the-user-created/EEE3088F-Team-9/README.md

# EEE3088F 2022 HAT Project

# License
[Creative Commons Attribution 4.0 International license](https://choosealicense.com/licenses/cc-by-4.0/)
