the-user-created/EEE3088F-Team-9/CAD/CAD_readme.md

# Project CAD files
This folder should contain files related to mechanical design for the project such as 3D printing or other container design files.
