the-user-created/EEE3088F-Team-9/Other/GROUP9_BOM.xlsx

 | Component Name | JLCPCB Code | Count (per board) | Cost ($) | Total Cost ($)
POWER | 1Ω Resistor | C17928 | 2 | 0.0051 | 0.0102
 | 1.2kΩ Resistor | C22765 | 3 | 0.0013 | 0.0039
 | 100kΩ Resistor | C17900 | 1 | 0.0038 | 0.0038
 | 33kΩ Resistor | C4216 | 1 | 0.0013 | 0.0013
 | Red LED | C84256 | 1 | 0.0136 | 0.0136
 | Green LED | C72043 | 1 | 0.0296 | 0.0296
 | 10uF Capacitor | C13585 | 3 | 0.0409 | 0.1227
 | 22uF Capacitor | C12891 | 3 | 0.0735 | 0.2205
 | 1uF Capacitor | C28323 | 1 | 0.0096 | 0.0096
 | 0.47uF Capacitor | C47339 | 1 | 0.002 | 0.002
 | Schottky diode | C8598 | 1 | 0.042 | 0.042
 | Battery mgmt IC | C16581 | 1 | 0.256 | 0.256
 | MCP6002 Op-amp | C7377 | 1 | 0.4035 | 0.4035
 | Inductor | C408336 | 1 | 0.2225 | 0.2225 | EXTENDED
 | Voltage booster | C130338 | 1 | 0.2937 | 0.2937 | EXTENDED
 | P-channel MOSFET | C8492 | 1 | 0.0273 | 0.0273
 | Voltage regulator | C140319 | 1 | 1.4949 | 1.4949 | EXTENDED
 | Total |  |  | $ | 3.1571 | plus $9 Ext
INTERFACING | Zener diode | C8056 | 3 | 0.0176 | 0.0528
 | Green LED | C72043 | 2 | 0.0296 | 0.0592
 | 0.1uF Capacitor | C1525 | 2 | 0.001 | 0.002
 | 1.0uF Capacitor | C15849 | 1 | 0.0055 | 0.0055
 | EEPROM IC (CAT24C256) | C6482 | 1 | 1.4287 | 1.4287
 | FTDI IC (CP2102-GMR) | C6568 | 1 | 3.5502 | 3.5502
 | USB Connector (MicroXNJ) | C404969 | 1 | 0.047 | 0.047 | EXTENDED
 | 1.2kΩ Resistor | C22765 | 2 | 0.0013 | 0.0026
 | 4.7kΩ Resistor | C23162 | 1 | 0.0012 | 0.0012
 | 10kΩ Resistor | C25804 | 2 | 0.0012 | 0.0024
 | Total |  |  | $ | 5.1516 | plus $3 Ext
SENSING | 0.1uF Capacitor | C1525 | 1 | 0.001 | 0.001
 | 1.0uF Capacitor | C15849 | 1 | 0.0055 | 0.0055
 | Barometer (LPS22HBTR) | C94049 | 1 | 2.4324 | 2.4324 | EXTENDED
 | Temp Sensor (LM61BIZ/NOPB) | C90846 | 1 | 0.9723 | 0.9723 | EXTENDED
 | Total |  |  | $ | 3.4112 | plus $6 Ext
 | Per Board Total |  |  | $ | 11.7199 | plus $18 Ext
 | 5 Board Total |  |  | $ | 76.5995 | plus $18 Ext
