the-user-created/EEE3088F-Team-9/Other/Sensor BOM.xlsx

Item | Qty | Reference(s) | Description | Value | LibPart | Price per part (approximate) | Total cost ($)
1 | 5 | C1 | Capacitor | 1uF | Device: C | $0.00843 | $0.04215
2 | 5 | C2 | Capacitor | 100nF | Device: C | $0.0011 | $0.0055
3 | 5 | U1 | Nano Barometer |  | C94049_Barometer | $2.6886 | $13.443
4 | 5 | U2 | Temperature Sensor |  | TO-92 Temperature Sensor | $1.0186 | $5.093
 |  |  |  |  |  | Grand Total: | $18.58365
