the-user-created/EEE3088F-Team-9/Other/MC_Interfacing_BOM.xlsx

Collated Components:
Item | Qty | Reference(s) | Description | Value | LibPart | Price per part (approximate) | Total cost ($)
1 | 1 | C7 | Capacitor | 1.0uF | Device:C_Small | $0.0281 | $0.0281
2 | 2 | C8, C9 | Capacitor | 0.1uF | Device:C_Small | $0.0050 | $0.01
3 | 1 | R 13 | Resistor | 4.7k | Device:R_US | $0.0013 | $0.0013
4 | 1 | R 14 | Resistor | 10k | Device:R_US | $0.0007 | $0.0007
5 | 3 | D6, D7, D8 | Zener Diode | N/A | Diode:ZMMxx | $0.0193 | $0.0579
6 | 1 | U6 | Memory Element | N/A | Memory_EEPROM:CAT24C256 | $1.5556 | $1.5556
7 | 1 | J5 | Micro USB Connector | N/A | Connector:USB_B_Micro | $0.2511 | $0.2511
10 | 1 | U7 | FTDI | N/A | custom_symbols:CP2102-GMR | $3.7227 | $3.7227
 |  |  |  |  |  | GRAND TOTAL PER HAT ($) | $5.6274
