the-user-created/EEE3088F-Team-9/Other/POWER_BOM.xlsx

Collated Components:
Item | Qty | Reference(s) | Description | Value | LibPart | Price per part (approximate) | Total cost ($)
1 | 1 | BT1 | Battery holder | Battery | Device:Battery | ???
2 | 2 | C1, C2 | Misc capacitor | C | Device:C | 0.01 | 0.02
3 | 1 | C3 | Exact capacitance | 0.47u | Device:C | 0.01 | 0.01
4 | 1 | C4 | Exact capacitance | 33u | Device:C | 0.01 | 0.01
5 | 2 | D1, D2 | LEDs | LED | Device:LED | 0.01 | 0.02
6 | 2 | D3, D4 | Volt. reg. diodes | D | Device:D | 0.01 | 0.02
7 | 1 | D5 | Zener diode | D_Zener | Device:D_Zener | 0.02 | 0.02
10 | 1 | Q1 | PMOS | Q_PMOS_DGS | Device:Q_PMOS_DGS | 0.2 | 0.2
11 | 12 | R1, R2, R3, R4, R5, R6, R7, R8, R9, R10, R11, R12 | Misc Resistors | R | Device:R | 0.01 | 0.12
12 | 1 | U1 | Battery mgmt. IC | TP4056 | 000_MY_SYMBOLS:TP4056 | 0.2 | 0.2
13 | 1 | U2 | Voltage regulator | LM3940 | 000_MY_SYMBOLS:LM3940 | 1.6 | 1.6
14 | 1 | U3 | Op-amp | OPAMP | pspice:OPAMP | 0.14 | 0.14
 |  |  |  |  |  | GRAND TOTAL PER HAT ($) | 2.36
