the-user-created/EEE3088F-Team-9/PCB/main/main.kicad_pcb

## KiCad design PCB/main/main.kicad_pcb (2022-04-08)

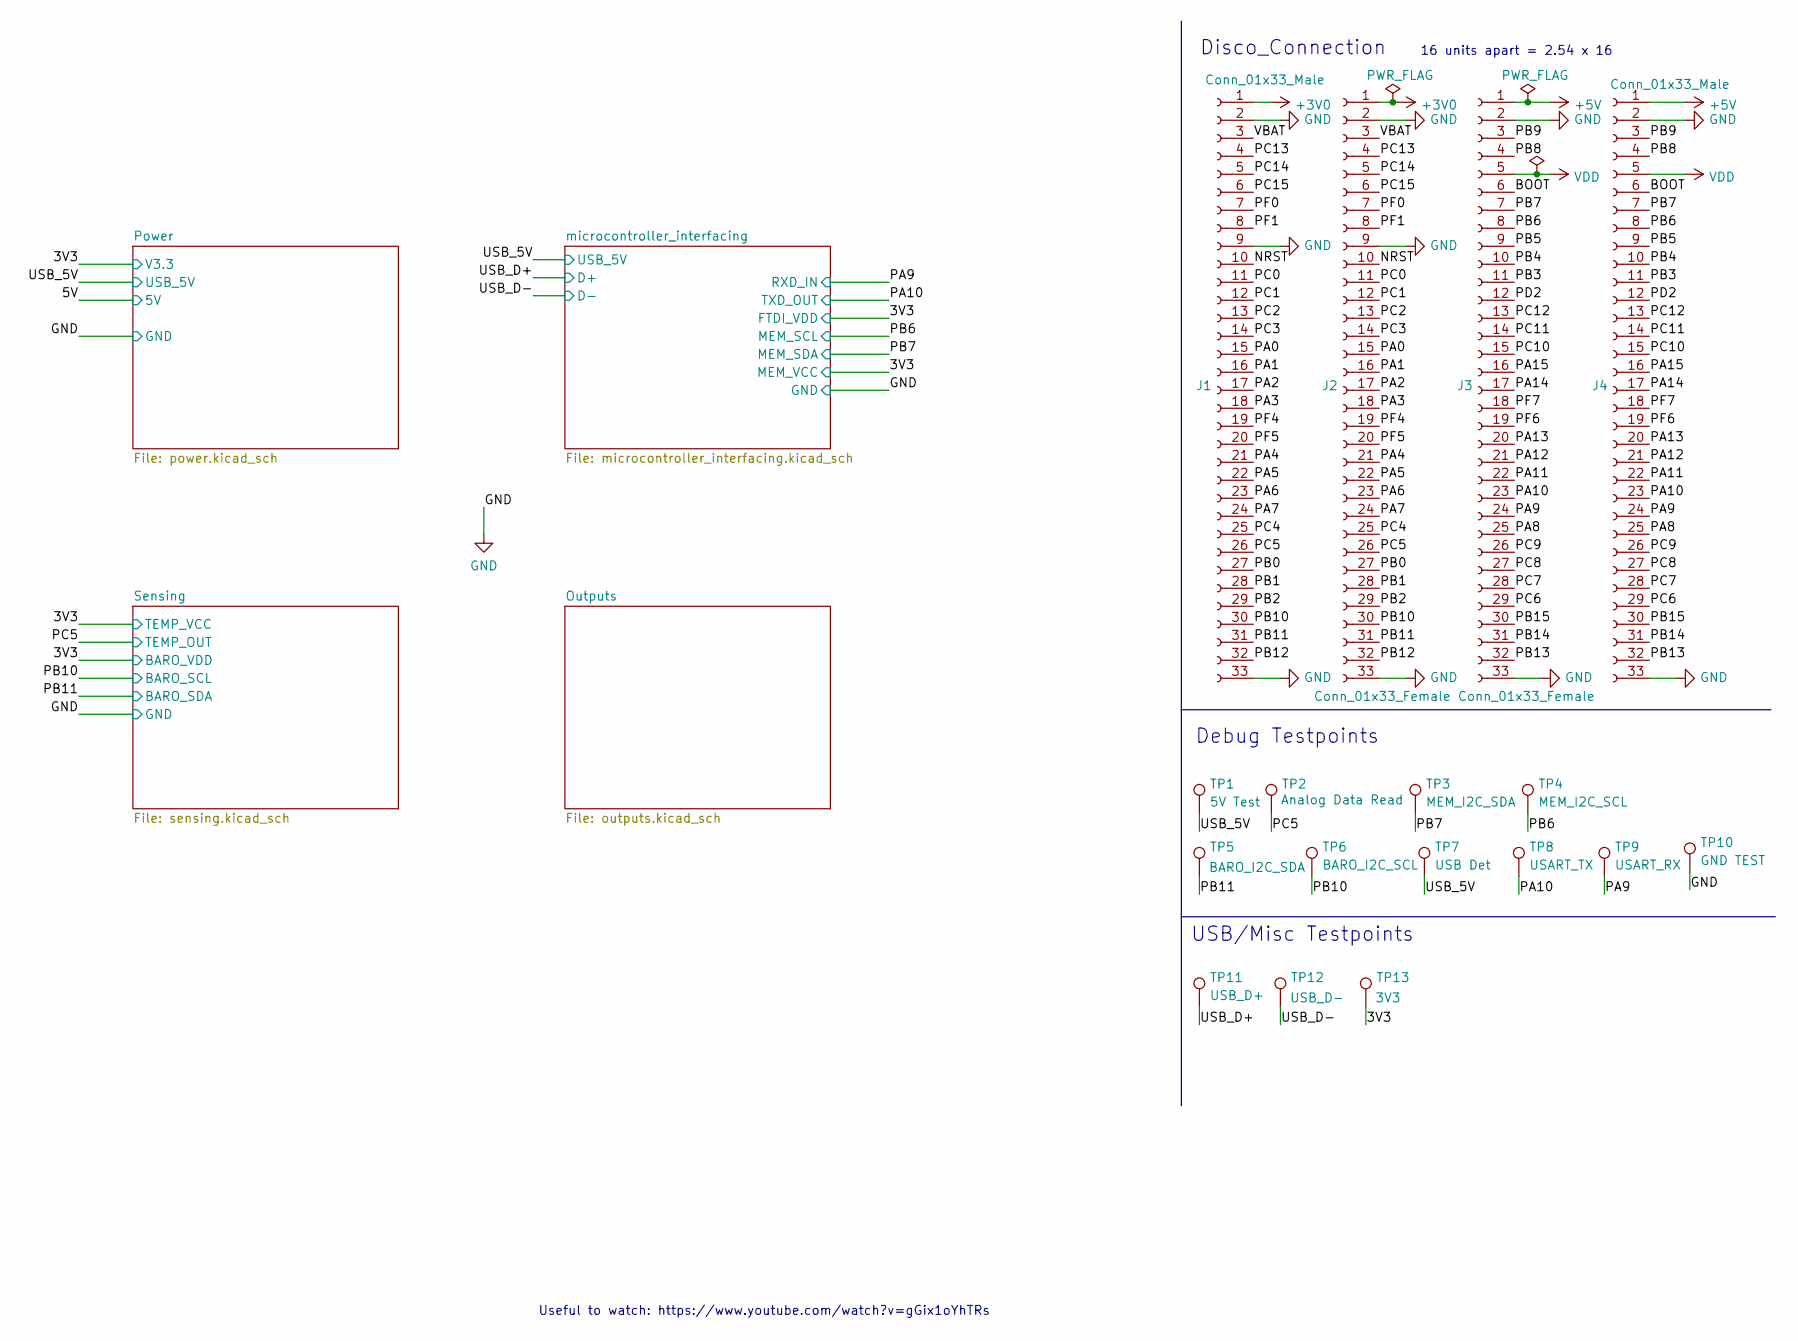
[picture p1: schematic main.kicad_sch, EEE3088F Group 9]

Parts:
J1, J4: Conn_01x33_Male; PinHeader_1x33_P2.54mm_Vertical
J2, J3: Conn_01x33_Female; PinSocket_1x33_P2.54mm_Vertical
TP1: 5V Test; TestPoint_Pad_2.5x2.5mm
TP2: Analog Data Read; TestPoint_Pad_2.5x2.5mm
TP3: MEM_I2C_SDA; TestPoint_Pad_2.5x2.5mm
TP4: MEM_I2C_SCL; TestPoint_Pad_2.5x2.5mm
TP5: BARO_I2C_SDA; TestPoint_Pad_2.5x2.5mm
TP6: BARO_I2C_SCL; TestPoint_Pad_2.5x2.5mm
TP7: USB Det; TestPoint_Pad_2.5x2.5mm
TP8: USART_TX; TestPoint_Pad_2.5x2.5mm
TP9: USART_RX; TestPoint_Pad_2.5x2.5mm
TP10: GND TEST; TestPoint_Pad_2.5x2.5mm
TP11: USB_D+; TestPoint_Pad_2.5x2.5mm
TP12: USB_D-; TestPoint_Pad_2.5x2.5mm
TP13: 3V3; TestPoint_Pad_2.5x2.5mm

Connections:
+3V0: J1.1, J2.1
+5V: J3.1, J4.1
/3V3: TP13.1; also elsewhere on the board
/BOOT: J3.6, J4.6
/NRST: J1.10, J2.10
/PA0: J1.15, J2.15
/PA1: J1.16, J2.16
/PA2: J1.17, J2.17
/PA3: J1.18, J2.18
/PA4: J1.21, J2.21
/PA5: J1.22, J2.22
/PA6: J1.23, J2.23
/PA7: J1.24, J2.24
/PA8: J3.25, J4.25
/PA9: J3.24, J4.24, TP9.1; also elsewhere on the board
/PA10: J3.23, J4.23, TP8.1; also elsewhere on the board
/PA11: J3.22, J4.22
/PA12: J3.21, J4.21
/PA13: J3.20, J4.20
/PA14: J3.17, J4.17
/PA15: J3.16, J4.16
/PB0: J1.27, J2.27
/PB1: J1.28, J2.28
/PB2: J1.29, J2.29
/PB3: J3.11, J4.11
/PB4: J3.10, J4.10
/PB5: J3.9, J4.9
/PB6: J3.8, J4.8, TP4.1; also elsewhere on the board
/PB7: J3.7, J4.7, TP3.1; also elsewhere on the board
/PB8: J3.4, J4.4
/PB9: J3.3, J4.3
/PB10: J1.30, J2.30, TP6.1; also elsewhere on the board
/PB11: J1.31, J2.31, TP5.1; also elsewhere on the board
/PB12: J1.32, J2.32
/PB13: J3.32, J4.32
/PB14: J3.31, J4.31
/PB15: J3.30, J4.30
/PC0: J1.11, J2.11
/PC1: J1.12, J2.12
/PC2: J1.13, J2.13
/PC3: J1.14, J2.14
/PC4: J1.25, J2.25
/PC5: J1.26, J2.26, TP2.1; also elsewhere on the board
/PC6: J3.29, J4.29
/PC7: J3.28, J4.28
/PC8: J3.27, J4.27
/PC9: J3.26, J4.26
/PC10: J3.15, J4.15
/PC11: J3.14, J4.14
/PC12: J3.13, J4.13
/PC13: J1.4, J2.4
/PC14: J1.5, J2.5
/PC15: J1.6, J2.6
/PD2: J3.12, J4.12
/PF0: J1.7, J2.7
/PF1: J1.8, J2.8
/PF4: J1.19, J2.19
/PF5: J1.20, J2.20
/PF6: J3.19, J4.19
/PF7: J3.18, J4.18
/USB_5V: TP1.1, TP7.1; also elsewhere on the board
/USB_D+: TP11.1; also elsewhere on the board
/USB_D-: TP12.1; also elsewhere on the board
/VBAT: J1.3, J2.3
GND: J1.2, J1.9, J1.33, J2.2, J2.9, J2.33, J3.2, J3.33, J4.2, J4.33, TP10.1; also elsewhere on the board
VDD: J3.5, J4.5

Notes on the sheet:
USB/Misc Testpoints
Useful to watch: https://www.youtube.com/watch?v=gGix1oYhTRs
16 units apart = 2.54 x 16
Disco_Connection
Debug Testpoints

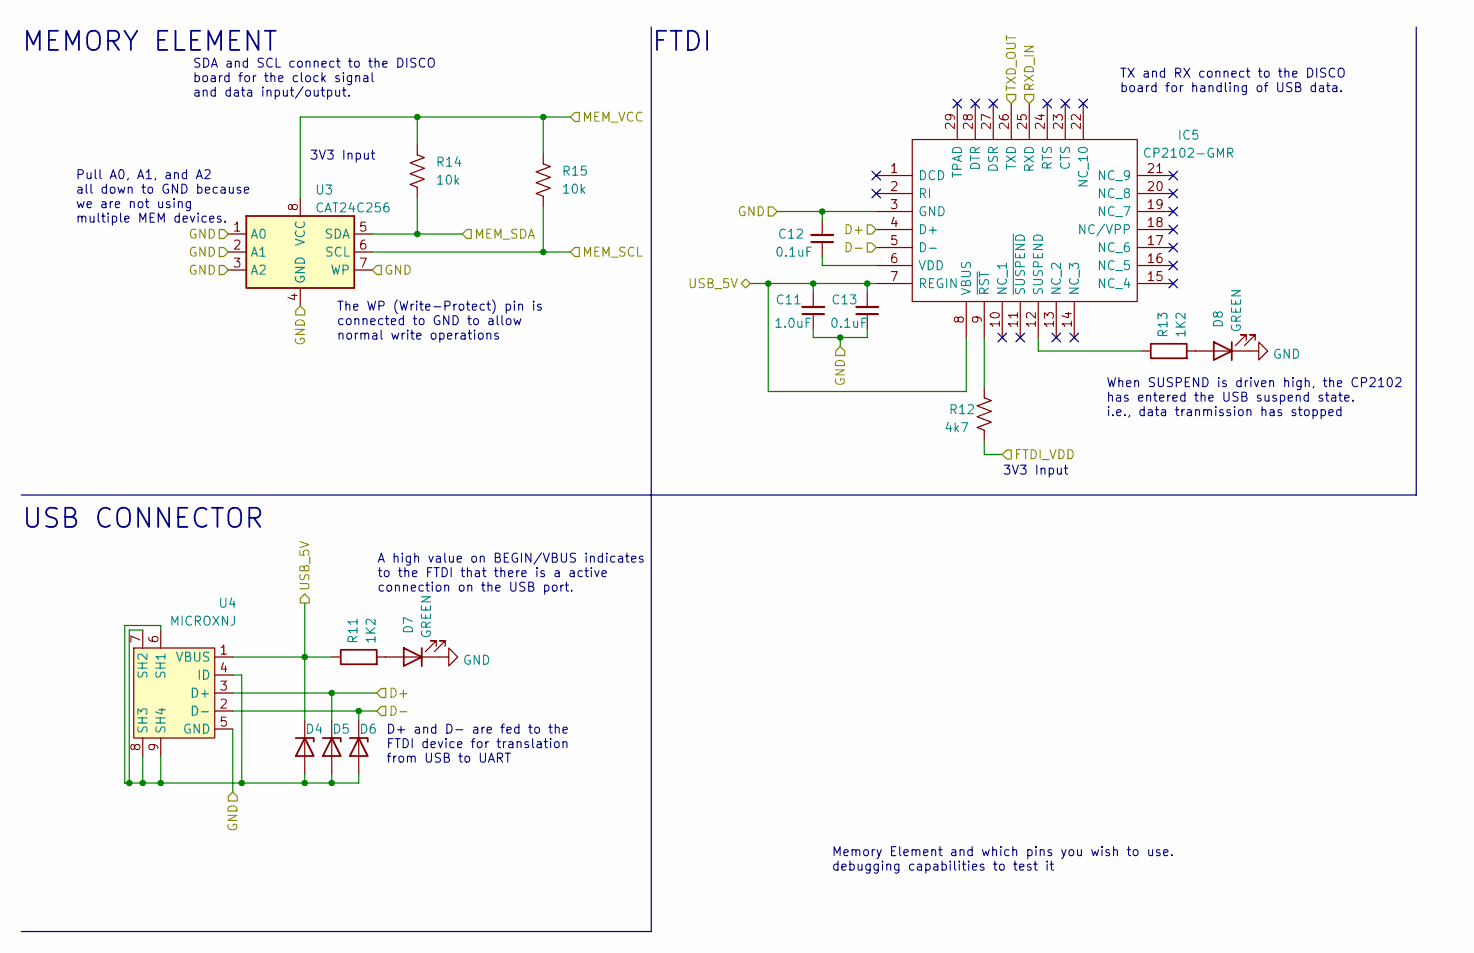
[picture p2: schematic microcontroller_interfacing.kicad_sch, Microcontroller Interfacing Subsystem]

Parts:
C11: 1.0uF; CAPC1608X90N; LCSC C15849
C12, C13: 0.1uF; CAPC1005X55N; LCSC C1525
D4, D5, D6: ZMMxx; LL-34_L3.5-W1.5-RD; LCSC C8056
D7, D8: GREEN; LEDC1608X50N; LCSC C72043
IC5: CP2102-GMR; QFN50P500X500X100-29N-D; Manufacturer_Part_Number CP2102-GMR; Mouser Part Number 634-CP2102-GMR
R11, R13: 1K2; RESC1608X55N; LCSC C22765
R12: 4k7; RESC1608X55N; LCSC C23162
R14, R15: 10k; R0603; LCSC C25804
U3: CAT24C256; SOIC127P600X175-8N; LCSC C6482
U4: MICROXNJ; MICRO-USB-SMD_MICROXNJ; LCSC C404969

Connections:
/3V3: R12.1, R14.1, R15.1, U3.8 (VCC); also elsewhere on the board
/PA9: IC5.25 (RXD); also elsewhere on the board
/PA10: IC5.26 (TXD); also elsewhere on the board
/PB6: R15.2, U3.6 (SCL); also elsewhere on the board
/PB7: R14.2, U3.5 (SDA); also elsewhere on the board
/USB_5V: C11.2, C13.2, D4.1 (K), IC5.7 (REGIN), IC5.8 (VBUS), R11.1, U4.1 (VBUS); also elsewhere on the board
/USB_D+: D5.1 (K), IC5.4 (D+), U4.3 (D+); also elsewhere on the board
/USB_D-: D6.1 (K), IC5.5 (D-), U4.2 (D-); also elsewhere on the board
GND: C11.1, C12.2, C13.1, D7.1 (K), D8.1 (K), IC5.3 (GND), U3.1 (A0), U3.2 (A1), U3.3 (A2), U3.4 (GND), U3.7 (WP), U4.5 (GND); also elsewhere on the board
unnamed: C12.1, IC5.6 (VDD)
unnamed: D4.2 (A), D5.2 (A), D6.2 (A), U4.4 (ID), U4.6 (SH1), U4.7 (SH2), U4.8 (SH3), U4.9 (SH4)
unnamed: D7.2 (A), R11.2
unnamed: D8.2 (A), R13.2
unnamed: IC5.9 (~RST), R12.2
unnamed: IC5.12 (SUSPEND), R13.1

Notes on the sheet:
3V3 Input
SDA and SCL connect to the DISCO board for the clock signal and data input/output.
FTDI
Pull A0, A1, and A2 all down to GND because we are not using multiple MEM devices.
MEMORY ELEMENT
The WP (Write-Protect) pin is connected to GND to allow normal write operations
TX and RX connect to the DISCO board for handling of USB data.
Memory Element and which pins you wish to use. debugging capabilities to test it
A high value on BEGIN/VBUS indicates to the FTDI that there is a active connection on the USB port.
D+ and D- are fed to the FTDI device for translation from USB to UART
When SUSPEND is driven high, the CP2102 has entered the USB suspend state. i.e., data tranmission has stopped
USB CONNECTOR

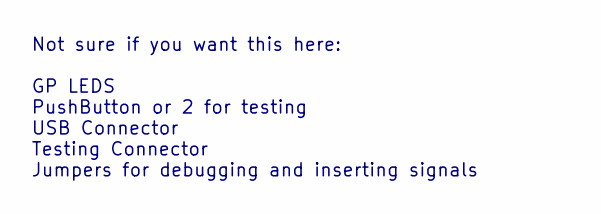
[picture p3: schematic outputs.kicad_sch]

Notes on the sheet:
Not sure if you want this here: GP LEDS PushButton or 2 for testing USB Connector Testing Connector Jumpers for debugging and inserting signals

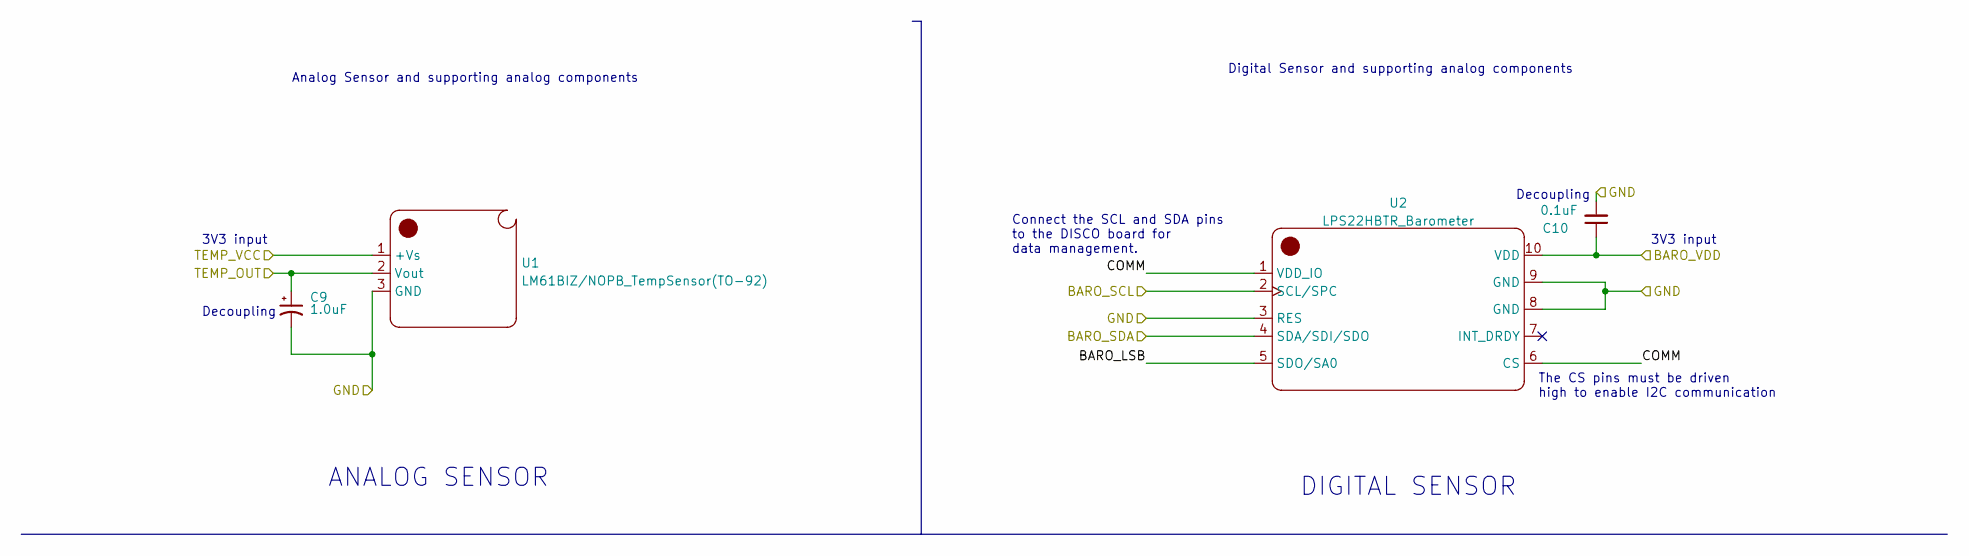
[picture p4: schematic sensing.kicad_sch, Sensing Subsystem]

Parts:
C9: 1.0uF; RESC1608X55N; LCSC C15849
C10: 0.1uF; CAPC1005X55N; LCSC C1525
U1: LM61BIZ/NOPB_TempSensor(TO-92); TO-92-3_L4.9-W3.7-P1.27-L; LCSC C90846
U2: LPS22HBTR_Barometer; QFN50P210X200X80-10N; LCSC C94049

Connections:
/3V3: C10.1, U1.1 (+Vs), U2.10 (VDD); also elsewhere on the board
/PB10: U2.2 (SCL/SPC); also elsewhere on the board
/PB11: U2.4 (SDA/SDI/SDO); also elsewhere on the board
/PC5: C9.1, U1.2 (Vout); also elsewhere on the board
/Sensing/BARO_LSB: U2.5 (SDO/SA0)
/Sensing/COMM: U2.1 (VDD_IO), U2.6 (CS)
GND: C9.2, C10.2, U1.3 (GND), U2.3 (RES), U2.8 (GND), U2.9 (GND); also elsewhere on the board

Notes on the sheet:
DIGITAL SENSOR
Decoupling
Analog Sensor and supporting analog components
3V3 input
ANALOG SENSOR
The CS pins must be driven high to enable I2C communication
Decoupling
Digital Sensor and supporting analog components
Connect the SCL and SDA pins to the DISCO board for data management.

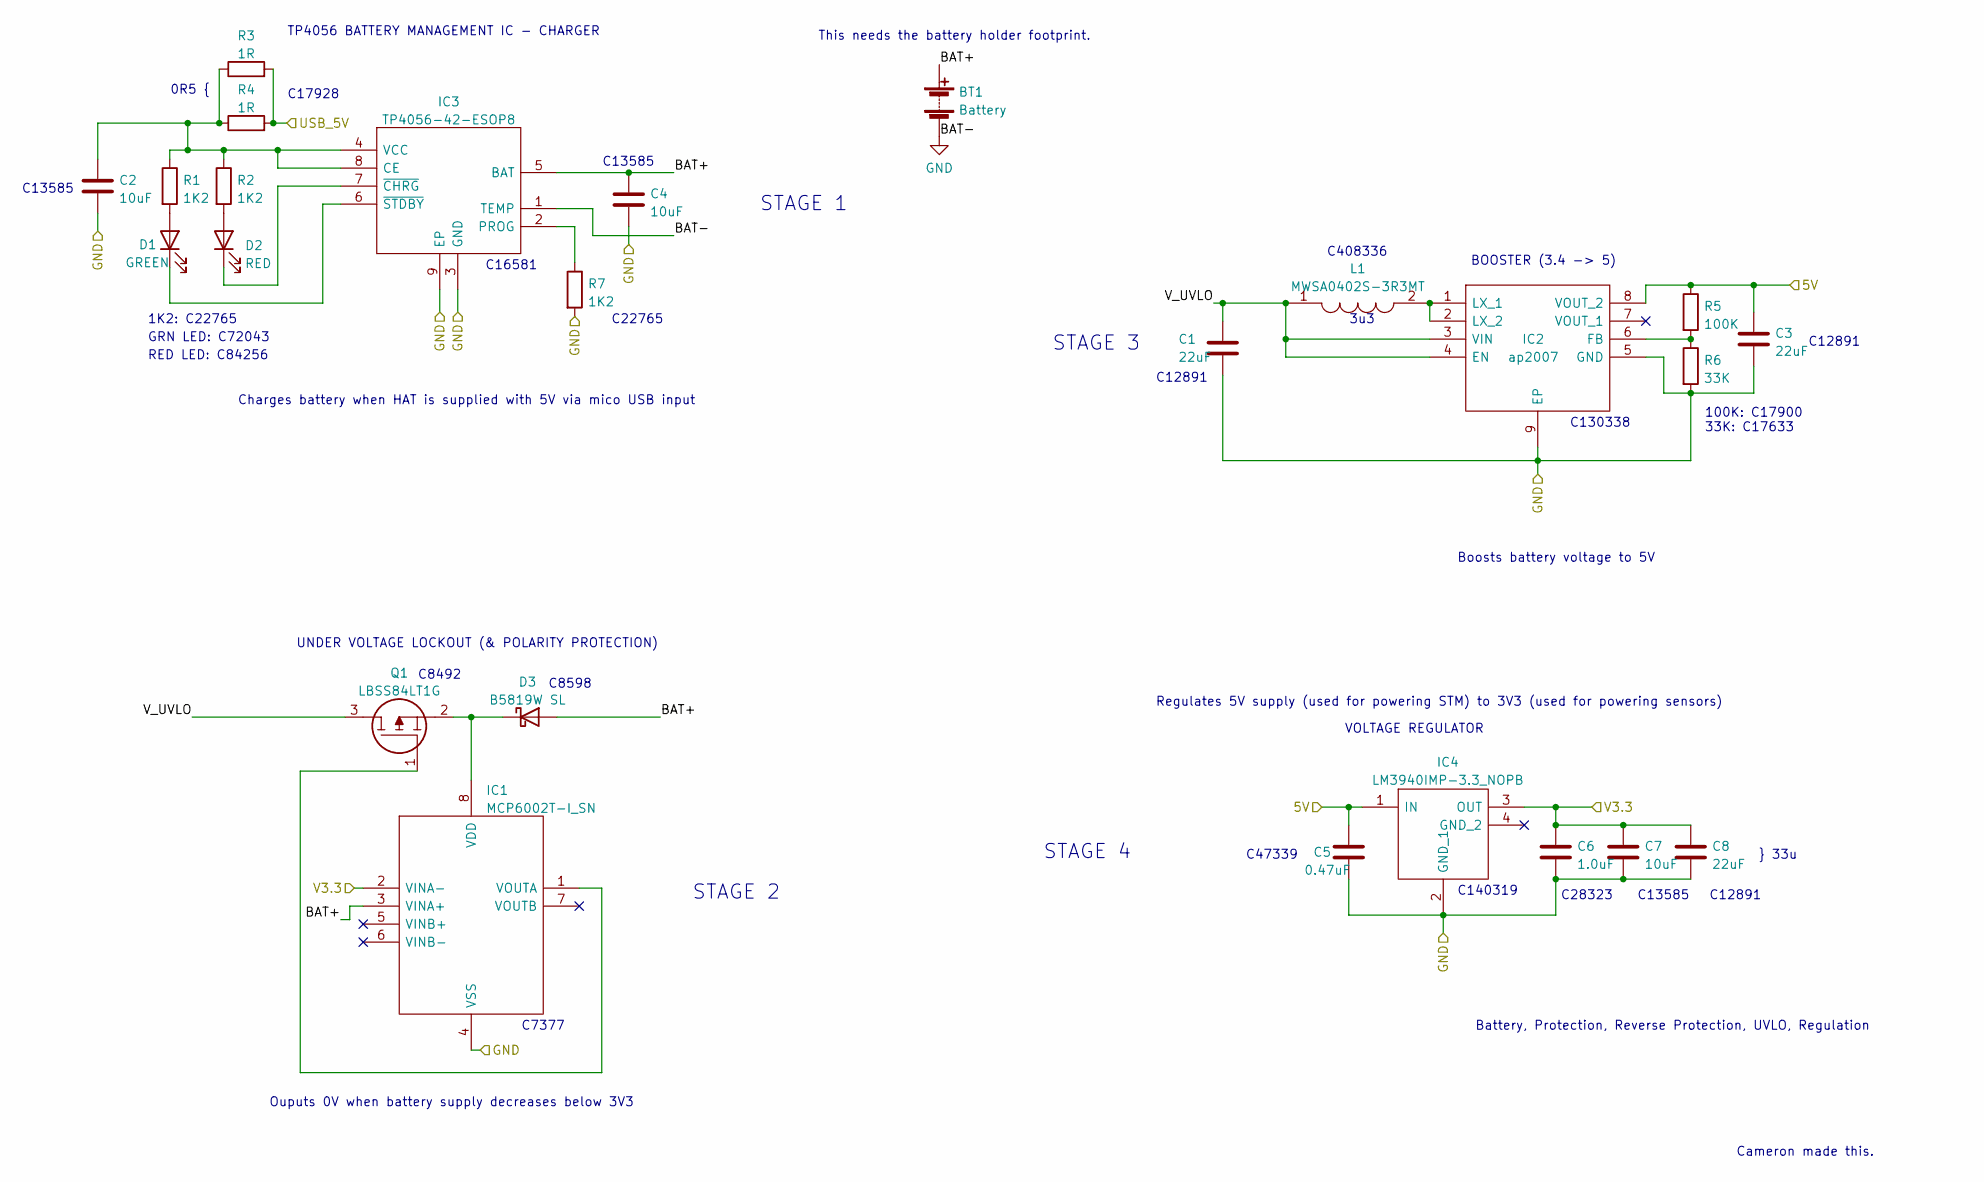
[picture p5: schematic power.kicad_sch, Power Subsystem]

Parts:
BT1: Battery; 18650_Holder_THT
C1, C3, C8: 22uF; CAPC3216X180N; LCSC C12891
C2, C4, C7: 10uF; CAPC3216X180N; LCSC C13585
C5: 0.47uF; CAPC1005X55N; LCSC C47339
C6: 1.0uF; CAPC1608X90N; LCSC C28323
D1: GREEN; LEDC1608X50N; LCSC C72043
D2: RED; LED0805-RD_RED; LCSC C84256
D3: B5819W SL; SOD-123_L2.7-W1.6-LS3.7-RD-1; LCSC C8598
IC1: MCP6002T-I_SN; SOIC127P600X175-8N; Manufacturer_Part_Number MCP6002T-I/SN; Mouser Part Number 579-MCP6002T-I/SN
IC2: ap2007; SOIC127P600X175-9N; Manufacturer_Part_Number ap2007; LCSC C130338
IC3: TP4056-42-ESOP8; SOIC127P600X175-9N; Manufacturer_Part_Number TP4056-42-ESOP8; LCSC C16581
IC4: LM3940IMP-3.3_NOPB; SOT230P700X180-4N; Manufacturer_Part_Number LM3940IMP-3.3/NOPB; Mouser Part Number 926-LM3940IMP3.3NOPB
L1: MWSA0402S-3R3MT; INDPM4442X200N; Manufacturer_Part_Number MWSA0402S-3R3MT; LCSC C408336
Q1: LBSS84LT1G; SOT96P237X111-3N; Manufacturer_Part_Number LBSS84LT1G; Mouser Part Number N/A
R1, R2, R7: 1K2; RESC1608X55N; LCSC C22765
R3, R4: 1R; R1206; LCSC C17928
R5: 100K; RESC3116X65N; LCSC C17900
R6: 33K; R0603; LCSC C4216

Connections:
/3V3: C6.1, C7.1, C8.1, IC1.2 (VINA-), IC4.3 (OUT); also elsewhere on the board
/5V: C3.1, C5.1, IC2.8 (VOUT_2), IC4.1 (IN), R5.1
/Power/BAT+: BT1.1 (+), C4.1, D3.2 (A), IC1.3 (VINA+), IC3.5 (BAT)
/Power/V_UVLO: C1.1, IC2.3 (VIN), IC2.4 (EN), L1.1, Q1.3
/USB_5V: R3.2, R4.2; also elsewhere on the board
GND: BT1.2 (-), C1.2, C2.2, C3.2, C4.2, C5.2, C6.2, C7.2, C8.2, IC1.4 (VSS), IC2.5 (GND), IC2.9 (EP), IC3.1 (TEMP), IC3.3 (GND), IC3.9 (EP), IC4.2 (GND_1), R6.2, R7.2; also elsewhere on the board
unnamed: C2.1, IC3.4 (VCC), IC3.8 (CE), R1.1, R2.1, R3.1, R4.1
unnamed: D1.1 (K), IC3.6 (~STDBY)
unnamed: D1.2 (A), R1.2
unnamed: D2.1 (K), IC3.7 (~CHRG)
unnamed: D2.2 (A), R2.2
unnamed: D3.1 (K), IC1.8 (VDD), Q1.2
unnamed: IC1.1 (VOUTA), Q1.1
unnamed: IC2.1 (LX_1), IC2.2 (LX_2), L1.2
unnamed: IC2.6 (FB), R5.2, R6.1
unnamed: IC3.2 (PROG), R7.1

Notes on the sheet:
C12891
STAGE 4
C17928
This needs the battery holder footprint.
C140319
BOOSTER (3.4 -> 5)
Boosts battery voltage to 5V
C8492
0R5 {
C13585
C28323
Charges battery when HAT is supplied with 5V via mico USB input
STAGE 3
STAGE 1
C22765
C408336
Ouputs 0V when battery supply decreases below 3V3
C16581
100K: C17900 33K: C17633
C130338
3u3
C47339
TP4056 BATTERY MANAGEMENT IC - CHARGER
UNDER VOLTAGE LOCKOUT (& POLARITY PROTECTION)
1K2: C22765
Battery, Protection, Reverse Protection, UVLO, Regulation
VOLTAGE REGULATOR
Regulates 5V supply (used for powering STM) to 3V3 (used for powering sensors)
RED LED: C84256
C7377
GRN LED: C72043
} 33u
Cameron made this.
STAGE 2
C8598

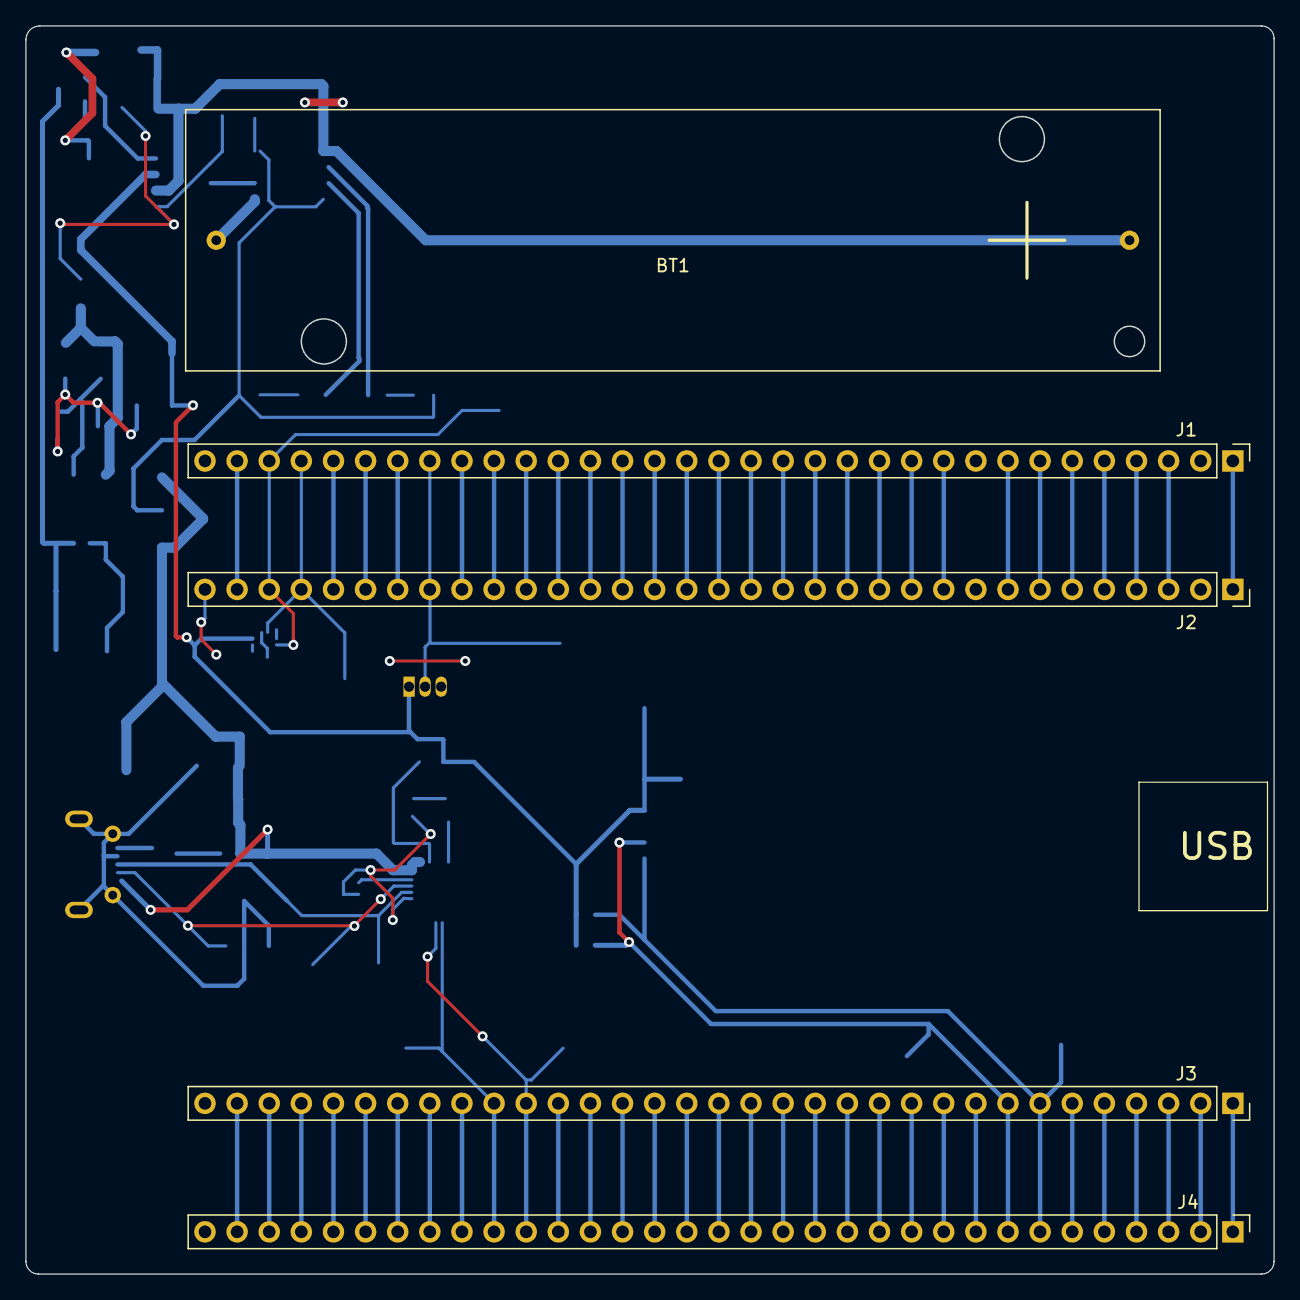
[picture p6: board main.kicad_pcb from above]

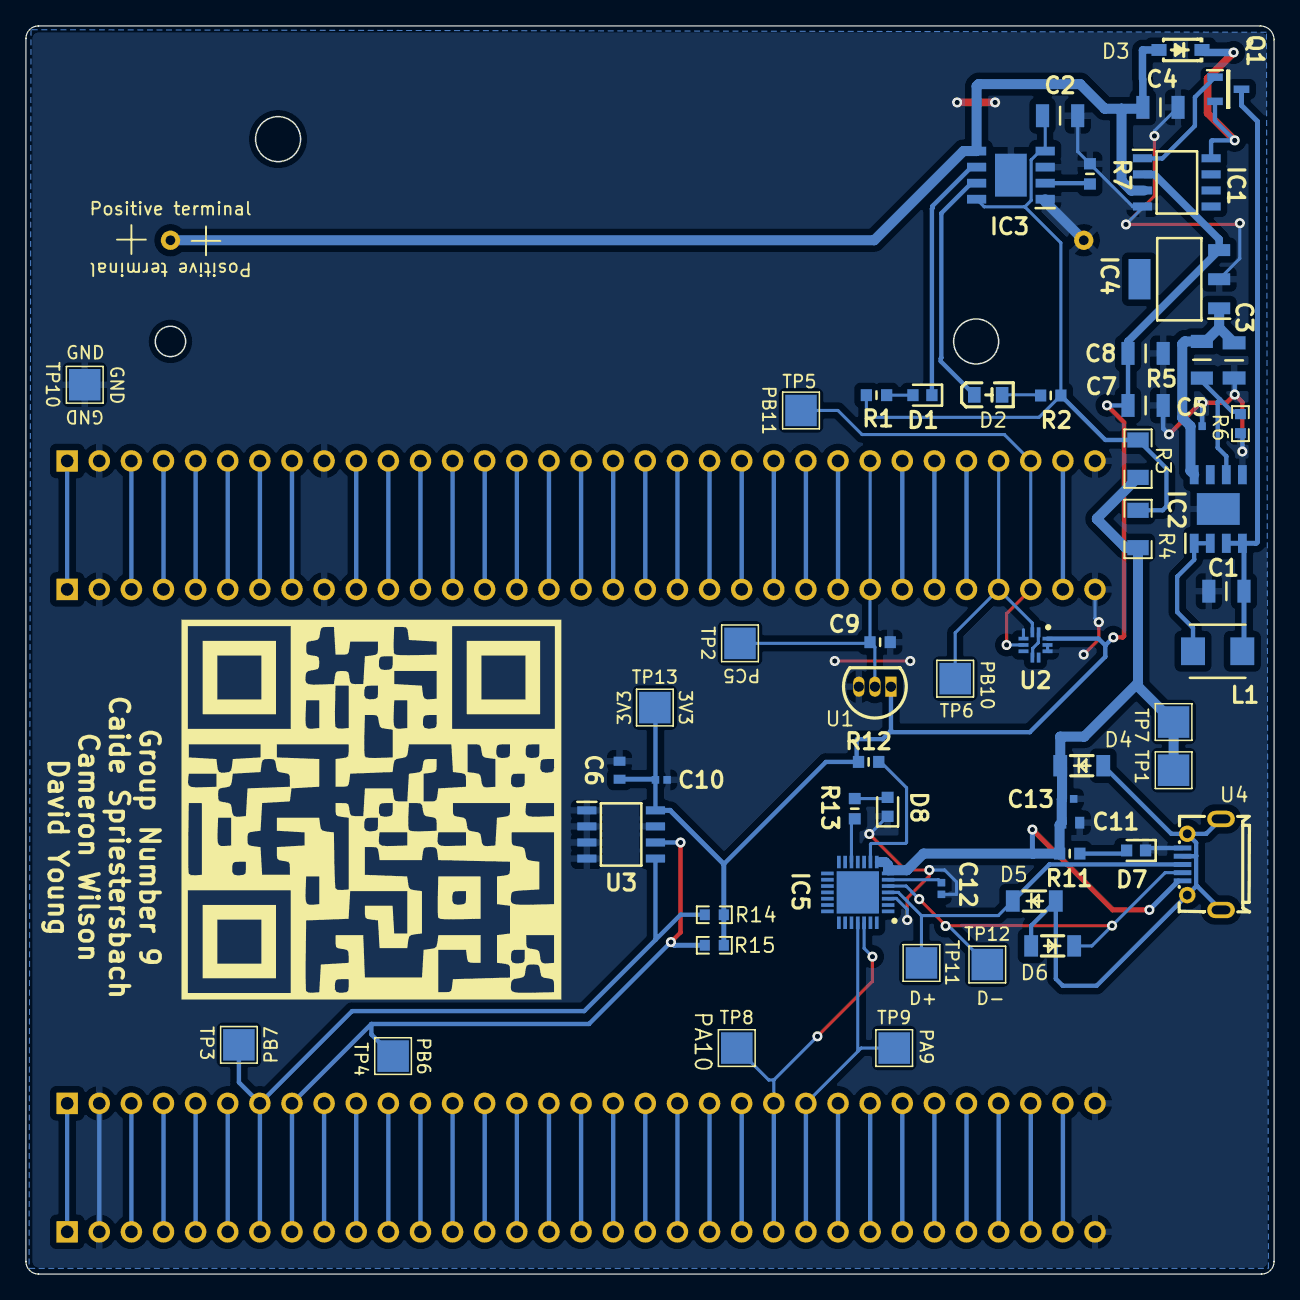
[picture p7: board main.kicad_pcb from below]

Board: 2 copper layers, 98.7 x 98.7 mm, 62 parts (57 on the bottom side), 86 nets.
