the-user-created/EEE3088F-Team-9/(commit log)

2022-03-04 Updated repo structure
    [example1_libraries.kicad_pcb, example1_libraries.kicad_sch, main.kicad_pcb, main.kicad_sch, microcontroller_interfacing.kicad_sch, outputs.kicad_sch, power.kicad_sch, sensing.kicad_sch]
2022-03-04 Added battery charger and polarity protection
    [main.kicad_sch, power.kicad_sch]
2022-03-04 Added UVLO and voltage regulation
    [main.kicad_sch, power.kicad_sch]
2022-03-04 Added global V3.3 label & power BOM
    [POWER BOM.xlsx, main.csv, main.kicad_sch, power.kicad_sch]
2022-03-04 Added most of the MC interface
    [main.kicad_sch, microcontroller_interfacing.kicad_sch, outputs.kicad_sch, power.kicad_sch, sensing.kicad_sch]
2022-03-04 Added main. and power.
    [main.kicad_sch, power.kicad_sch]
2022-03-04 Added Added global V3.3 label & power BOM again
    [POWER BOM.xlsx]
2022-03-04 Added Added global V3.3 label & power BOM again again
    [main.kicad_sch, power.kicad_sch]
2022-03-04 Added sensing schematic
    [sensing.kicad_sch]
2022-03-05 Finished v0.1 of MC Interfacing schem
    [MC_Interfacing_BOM.xlsx, POWER_BOM.xlsx, main.csv, main.kicad_sch, microcontroller_interfacing.kicad_sch, power.kicad_sch, sensing.kicad_sch]
2022-03-05 Added the sensing BOM
    [Sensor BOM.xlsx]
2022-03-11 Updated power subsystem to V0.3
    [main.kicad_sch, power.kicad_sch]
2022-03-11 Added references to components
    [main.kicad_sch, power.kicad_sch]
2022-03-11 Updated interfacing schem
    [main.kicad_sch, microcontroller_interfacing.kicad_sch, power.kicad_sch]
2022-03-11 Finished initial interfacing schem
    [main.kicad_sch, microcontroller_interfacing.kicad_sch, power.kicad_sch]
2022-03-11 Finished initial design
    [main.kicad_sch, microcontroller_interfacing.kicad_sch, outputs.kicad_sch, power.kicad_sch, sensing.kicad_sch]
2022-03-11 Finished BOM
    [GROUP9_BOM.xlsx, main.csv, main.kicad_sch, power.kicad_sch, sensing.kicad_sch]
2022-03-11 some touches
    [power.kicad_sch]
2022-03-15 Fiddled a bit with labels
    [main.kicad_sch, microcontroller_interfacing.kicad_sch, power.kicad_sch, sensing.kicad_sch]
2022-03-16 Added Footprint and symbol files
    [example1_libraries.kicad_pcb, example1_libraries.kicad_sch, main.kicad_sch, microcontroller_interfacing.kicad_sch, power.kicad_sch, sensing.kicad_sch]
2022-03-17 Annotated power schem, HAVE NOT ADDED INDUCTOR. v0.4
    [main.kicad_sch, microcontroller_interfacing.kicad_sch, power.kicad_sch]
2022-03-17 Added datasheets and footprints
2022-03-17 Fixed orientation of MOSFET in UVLO. Did not add power switch due to budget. Annotated UVLO inductor. v0.4
    [main.kicad_sch, power.kicad_sch]
2022-03-17 Updated all footprints of components
    [main.kicad_sch, microcontroller_interfacing.kicad_sch, power.kicad_sch, sensing.kicad_sch]
2022-03-17 Updated kicad_pcb file
    [main.kicad_pcb]
2022-03-18 Updated labels on schematic
    [main.kicad_sch, microcontroller_interfacing.kicad_sch, power.kicad_sch, sensing.kicad_sch]
2022-03-19 Began PCB layout
    [main.kicad_pcb, microcontroller_interfacing.kicad_sch, power.kicad_sch, sensing.kicad_sch]
2022-03-19 Fixed USB footprint and symbol
    [main.kicad_sch, microcontroller_interfacing.kicad_sch, power.kicad_sch, sensing.kicad_sch]
2022-03-19 Connected voltage supply from USB to power subsystem
    [main.kicad_pcb, main.kicad_sch, microcontroller_interfacing.kicad_sch, power.kicad_sch, sensing.kicad_sch]
2022-03-19 Completed the PCB wiring
    [main.kicad_pcb]
2022-03-20 Fixed up some of the wiring on the PCB
    [main.kicad_pcb]
2022-03-20 Ran ERC and DRV
    [main.kicad_pcb, main.kicad_sch, microcontroller_interfacing.kicad_sch, power.kicad_sch, sensing.kicad_sch]
2022-03-20 Finalised and generated Gerbers.
    [Sensor BOM.xlsx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]
2022-03-20 Just some touches
    [GROUP9_BOM.xlsx, main.csv]
2022-03-20 Updated power system BOM in GROUP9_BOM
    [GROUP9_BOM.xlsx]
2022-04-05 Added the contributors, the project name and revised the gradescope comments.
    [main.kicad_pcb]
2022-04-05 Updated MC Interfacing with pullups
    [main.kicad_pcb, main.kicad_sch, microcontroller_interfacing.kicad_sch, power.kicad_sch]
2022-04-08 Added ground to batt-
    [main.kicad_sch, microcontroller_interfacing.kicad_sch, power.kicad_sch, sensing.kicad_sch]
2022-04-08 Added MCP6002 OpAmp files
    [GROUP9_BOM.xlsx, main.kicad_sch, microcontroller_interfacing.kicad_sch, power.kicad_sch]
2022-04-08 Added thermal ground connects for batt reg and 3v3 reg. Replaced opamp with r2r opamp
    [main.kicad_sch]
2022-04-08 Updated footprints
    [main.kicad_pcb, main.kicad_sch, microcontroller_interfacing.kicad_sch, power.kicad_sch, sensing.kicad_sch]
2022-04-08 Fixed a lot of shit. Added 3 test pads. Rounded PCB corners
    [main.kicad_pcb, main.kicad_sch, power.kicad_sch, sensing.kicad_sch]
2022-04-08 Updated PCB with testpads
    [main.kicad_pcb, main.kicad_sch, microcontroller_interfacing.kicad_sch, power.kicad_sch, sensing.kicad_sch]
2022-04-08 Finished Gerbers and updated BOM
    [GROUP9_BOM.xlsx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]
2022-04-08 Updated Gerbers and DNPs
    [main-B_Cu.gbl, main-B_Mask.gbs, main-B_Paste.gbp, main-B_Silkscreen.gbo, main-Edge_Cuts.gm1, main-F_Cu.gtl, main-F_Mask.gts, main-F_Paste.gtp]
2022-04-25 nothing major
    [BOM.csv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]
